kingzarII/Modular-Smart-Lighting-Control-System/Screenshot 2026-08-19 at 21.22.18.png

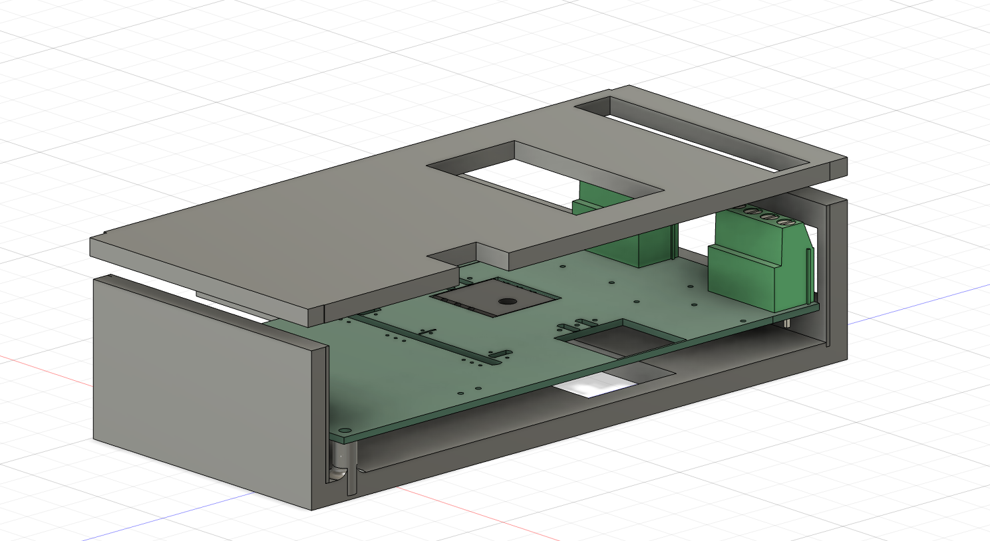
Screenshot 2026-08-19 at 21.22.18.png
