kingzarII/Modular-Smart-Lighting-Control-System/DimmerModule.step

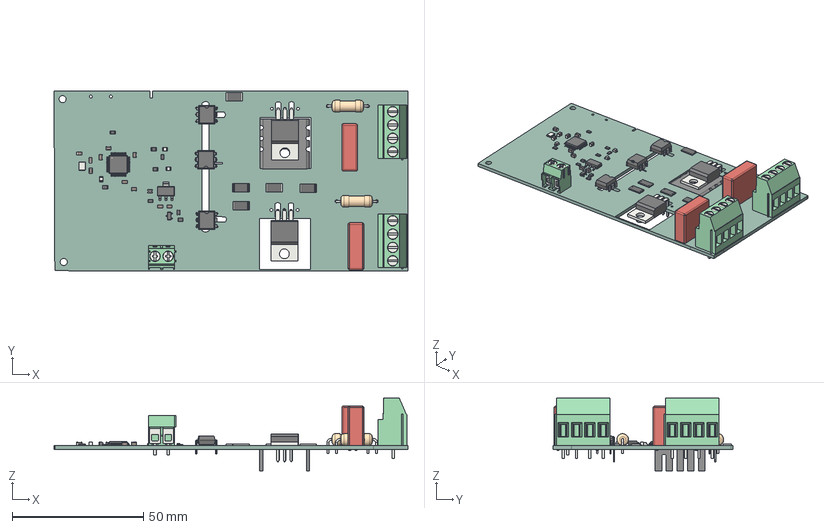
[picture p11: CAD file, 2026-08-20]
DimmerModule.step
134.8 x 68.6 x 27.7 mm
R_2512_6332Metric x 5
TO-220-3_Horizontal_TabDown x 2
LED_0805_2012Metric x 3
C_0805_2012Metric x 10
D_0805_2012Metric x 2
R_0805_2012Metric x 7
C_Rect_L18.0mm_W6.0mm_P15.00mm_FKS3_FKP3 x 2
Crystal_SMD_3225-4Pin_3.2x2.5mm
R_Axial_DIN0414_L11.9mm_D4.5mm_P15.24mm_Horizontal x 2
DIP-6_W7.62mm x 3
LQFP-48_7x7mm_P0.5mm
TerminalBlock_Phoenix_MKDS-3-4-5.08_1x04_P5.08mm_Horizontal x 2
507302B00000G--3DModel-STEP-56544
SOT-23
SOT-223
TerminalBlock_Phoenix_PT-1,5-2-5.0-H_1x02_P5.00mm_Horizontal
DimmerModule_PCB_1
DimmerModule_PCB_2
DimmerModule_PCB_3
