kingzarII/Modular-Smart-Lighting-Control-System/LinkedPartsPCB_Configuration 1_TESTPE1&.stl

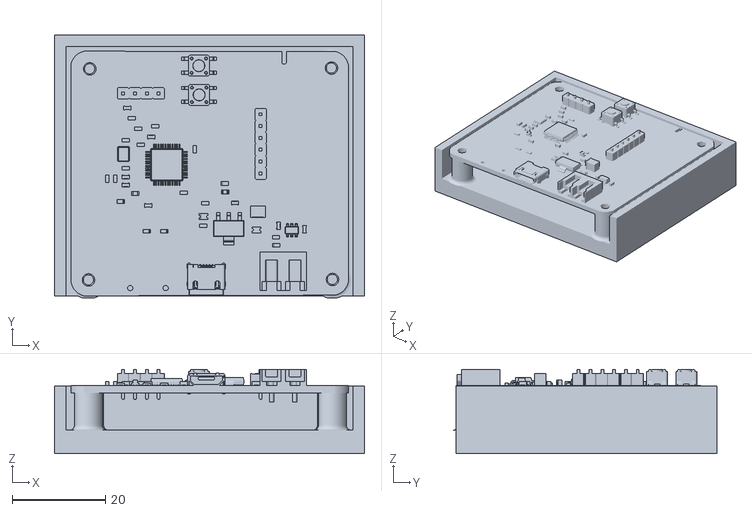
[picture p12: CAD file, 2026-08-20]
LinkedPartsPCB_Configuration 1_TESTPE1&.stl
66.6 x 56.6 x 18.1
