kingzarII/Modular-Smart-Lighting-Control-System/LinkedPartsPCB_Configuration 1_DimmerModuleCase2.stl

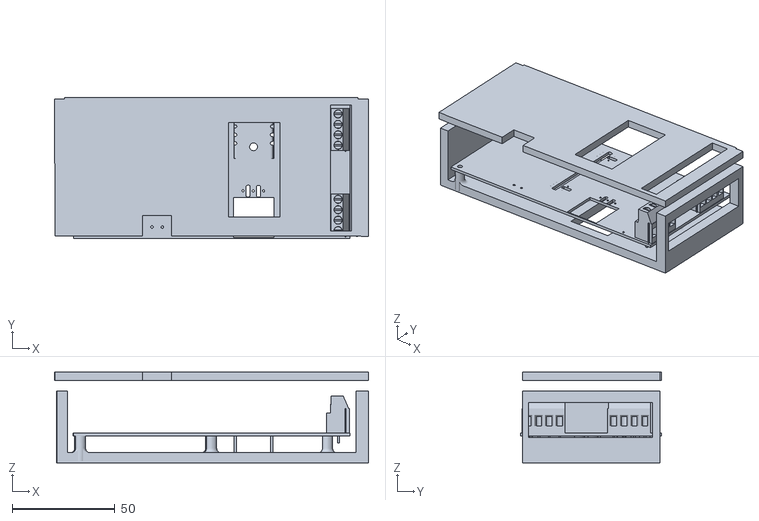
[picture p13: CAD file, 2026-08-20]
LinkedPartsPCB_Configuration 1_DimmerModuleCase2.stl
152.8 x 68.8 x 44.2
