kingzarII/Modular-Smart-Lighting-Control-System/TESTPE1.step

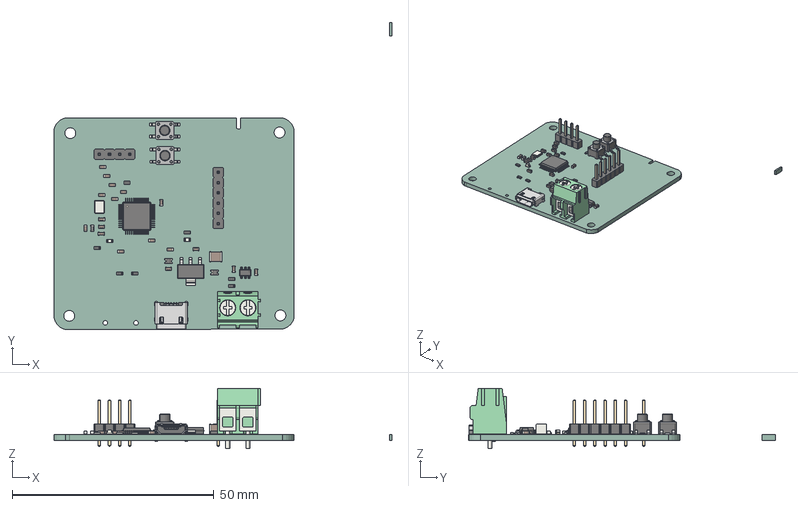
[picture p14: CAD file, 2026-08-20]
TESTPE1.step
83.9 x 76.2 x 15.0 mm
C_0603_1608Metric x 18
SOT-223
SW_SPST_TL3305B x 2
LQFP-48_7x7mm_P0.5mm
PinHeader_1x06_P2.54mm_Vertical
SOT-23-6
R_0603_1608Metric x 7
LED_0603_1608Metric x 2
Crystal_SMD_3225-4Pin_3.2x2.5mm
D_0805_2012Metric x 2
C_1210_3225Metric
TerminalBlock_Phoenix_PT-1,5-2-5.0-H_1x02_P5.00mm_Horizontal
629105150521_Housing
629105150521_Pin1 x 4
629105150521_Pin2
629105150521_Shielding2
629105150521_Shielding
PinHeader_1x04_P2.54mm_Vertical
L_0603_1608Metric
TESTPE1_PCB_1
TESTPE1_PCB_2
