kingzarII/Modular-Smart-Lighting-Control-System/Solo_dim_base.stl

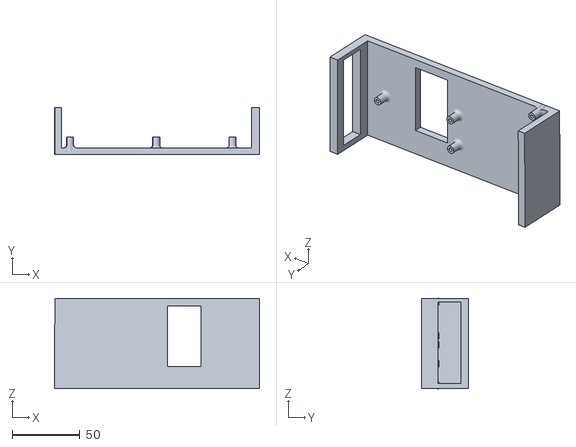
[picture p15: CAD file, 2026-08-20]
Solo_dim_base.stl
151.8 x 34.9 x 67.0
