kingzarII/Modular-Smart-Lighting-Control-System/Solo_Dim_Lid.stl

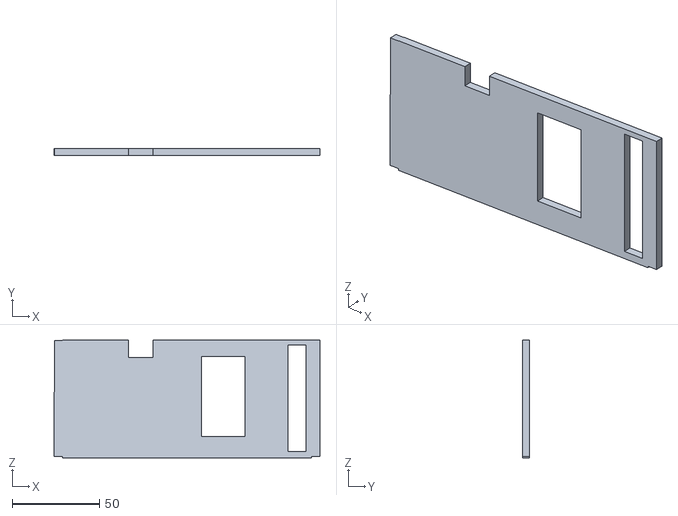
[picture p16: CAD file, 2026-08-20]
Solo_Dim_Lid.stl
152.8 x 4.00 x 67.6
