kingzarII/Modular-Smart-Lighting-Control-System/Solo_Base.stl

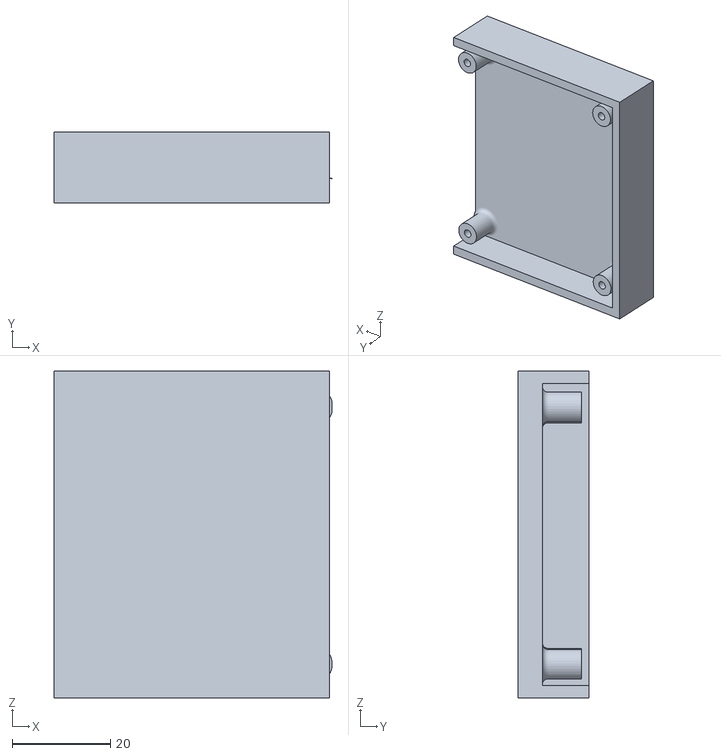
[picture p17: CAD file, 2026-08-20]
Solo_Base.stl
56.6 x 14.5 x 66.6
