kingzarII/Modular-Smart-Lighting-Control-System/DimmerModule.kicad_pcb

## KiCad design DimmerModule.kicad_pcb (2026-08-20)

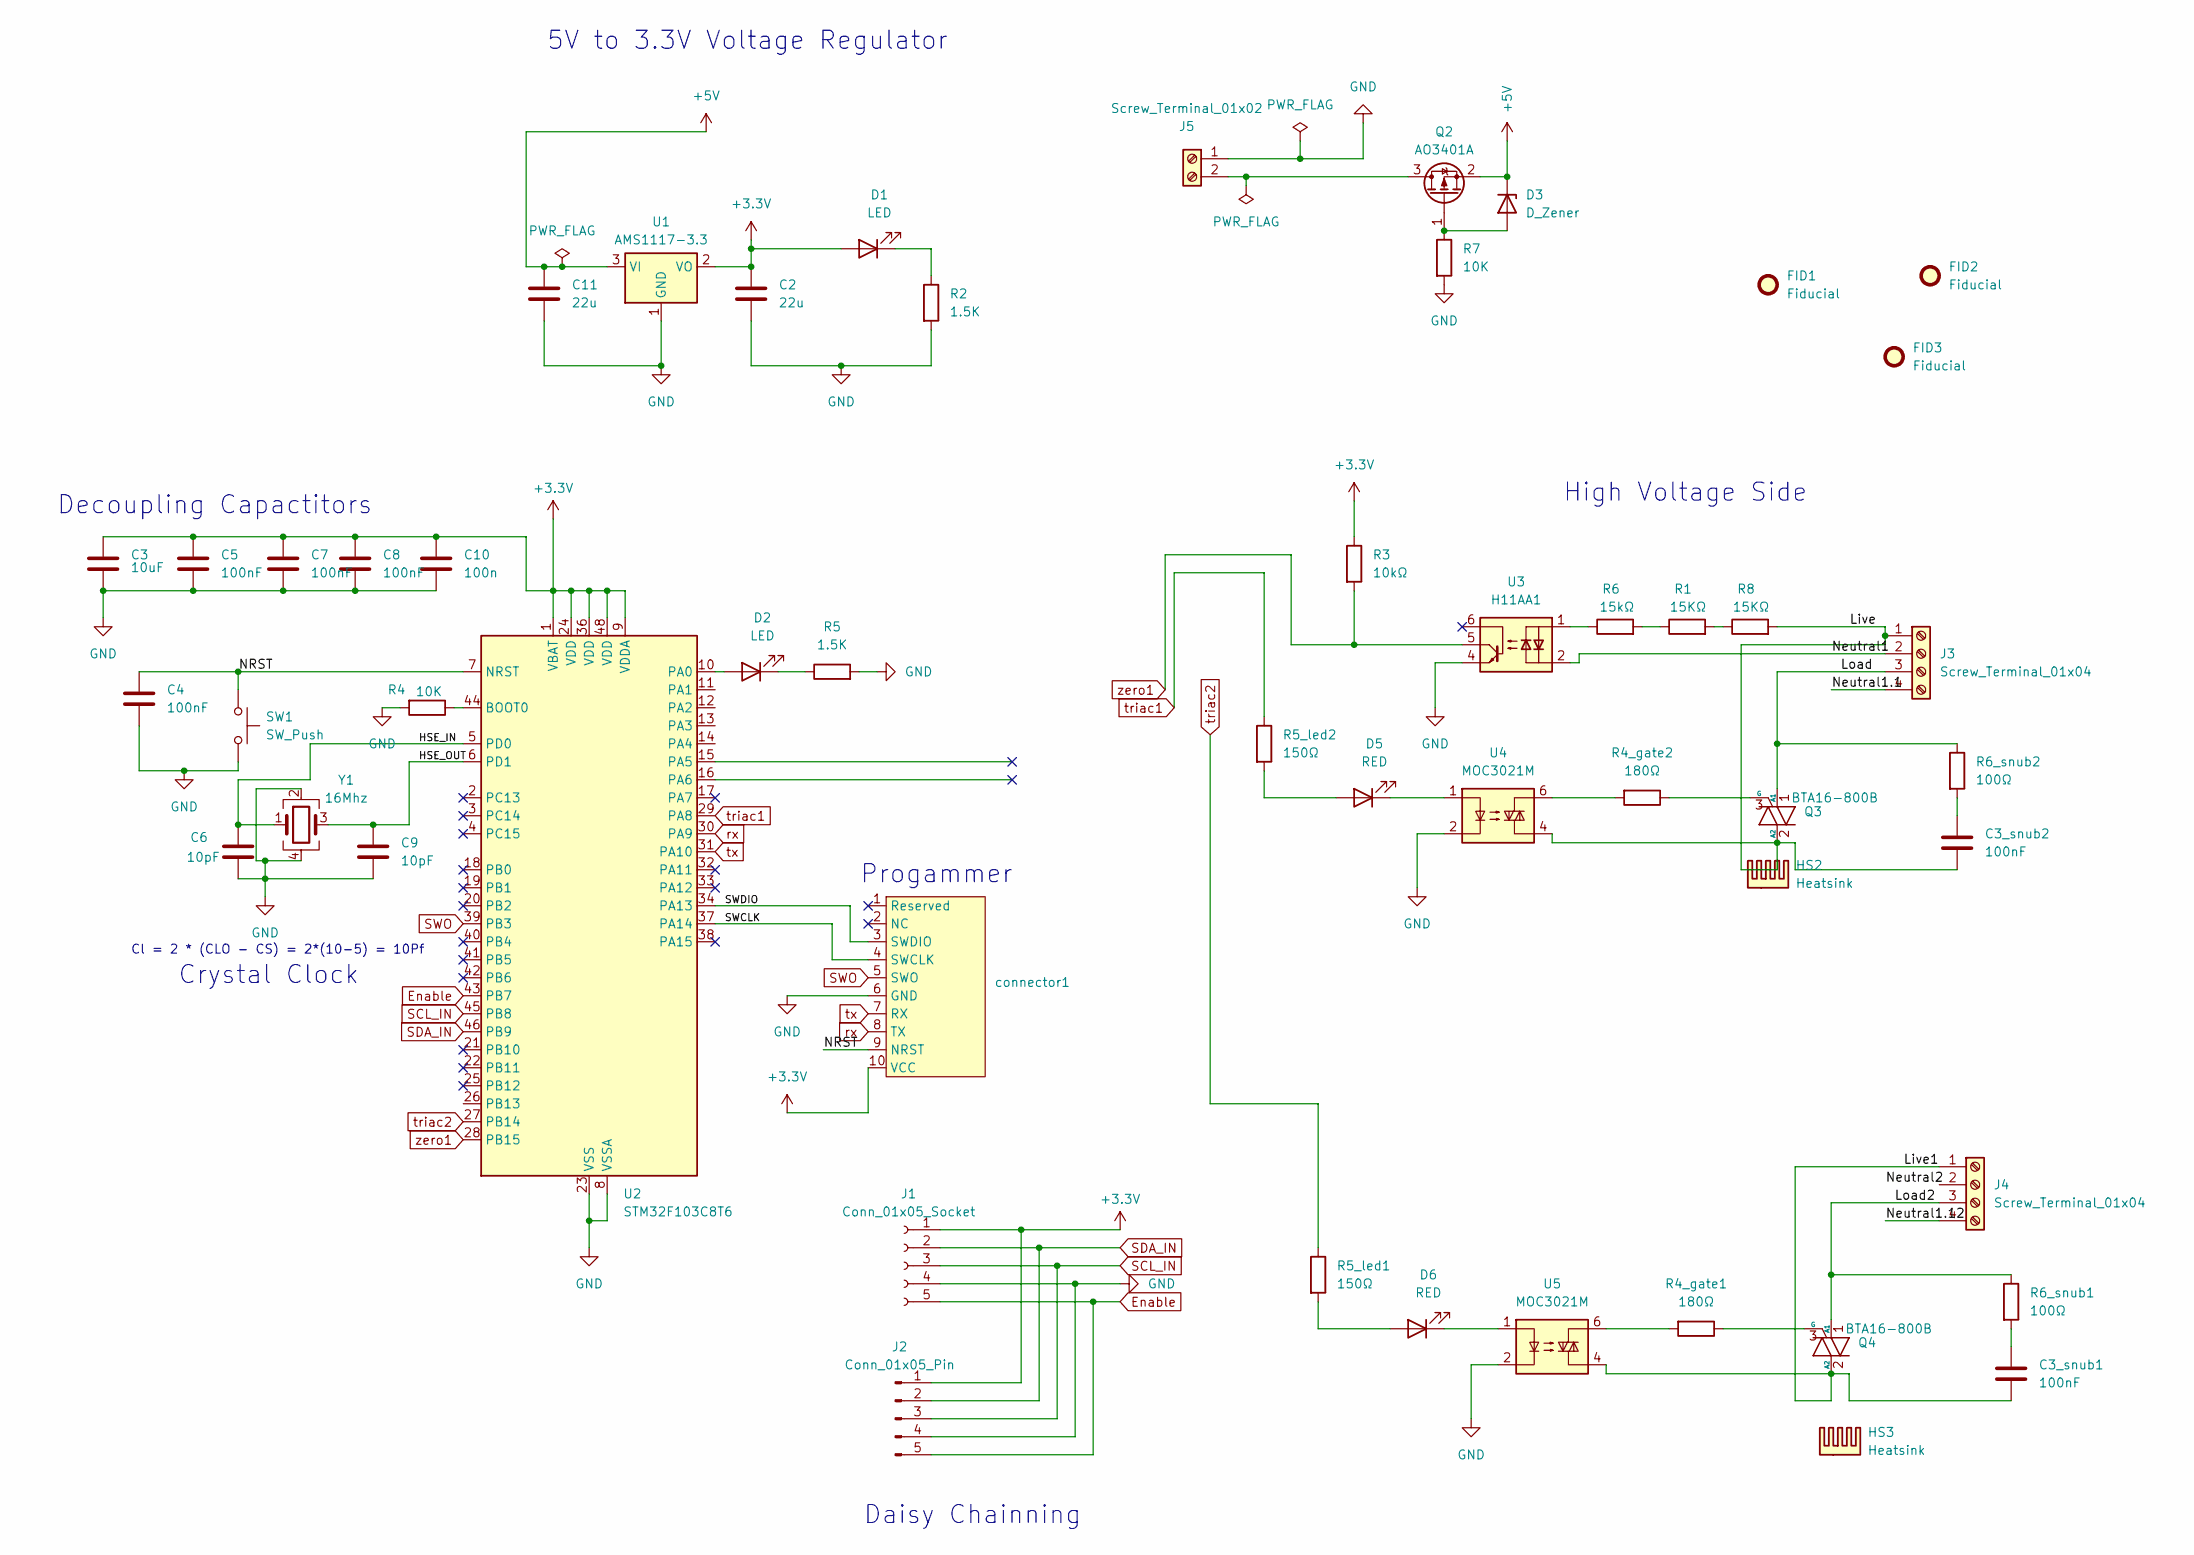
[picture p18: schematic DimmerModule.kicad_sch]

Parts:
C2, C11: 22u; C_0805_2012Metric
C3: 10uF; C_0805_2012Metric
C3_snub1, C3_snub2: 100nF; C_Rect_L18.0mm_W6.0mm_P15.00mm_FKS3_FKP3
C4, C5, C7, C8: 100nF; C_0805_2012Metric
C6, C9: 10pF; C_0805_2012Metric
C10: 100n; C_0805_2012Metric
D1: LED; D_0805_2012Metric
D2: LED; LED_0805_2012Metric
D3: D_Zener; D_0805_2012Metric
D5, D6: RED; LED_0805_2012Metric
FID1, FID2, FID3: Fiducial; Fiducial_1mm_Mask2mm
HS2, HS3: Heatsink; cooler
J1: Conn_01x05_Socket; 1156901
J2: Conn_01x05_Pin; 1156939
J3, J4: Screw_Terminal_01x04; TerminalBlock_Phoenix_MKDS-3-4-5.08_1x04_P5.08mm_Horizontal
J5: Screw_Terminal_01x02; TerminalBlock_Phoenix_PT-1,5-2-5.0-H_1x02_P5.00mm_Horizontal
Q2: AO3401A; SOT-23
Q3, Q4: BTA16-800B; TO-220-3_Horizontal_TabDown
R1, R8: 15KΩ; R_2512_6332Metric
R2, R5: 1.5K; R_0805_2012Metric
R3: 10kΩ; R_0805_2012Metric
R4, R7: 10K; R_0805_2012Metric
R4_gate1, R4_gate2: 180Ω; R_2512_6332Metric
R5_led1, R5_led2: 150Ω; R_0805_2012Metric
R6: 15kΩ; R_2512_6332Metric
R6_snub1, R6_snub2: 100Ω; R_Axial_DIN0414_L11.9mm_D4.5mm_P15.24mm_Horizontal
SW1: SW_Push; SW_SPST_TL3305B
U1: AMS1117-3.3; SOT-223-3_TabPin2
U2: STM32F103C8T6; LQFP-48_7x7mm_P0.5mm
U3: H11AA1; DIP-6_W7.62mm
U4, U5: MOC3021M; DIP-6_W7.62mm
Y1: 16Mhz; Crystal_SMD_3225-4Pin_3.2x2.5mm
connector1: Open Ended Card Edge

Connections:
+3.3V: C2.1, C3.1, C5.1, C7.1, C8.1, C10.1, D1.2 (A), J1.1, J2.1, R3.1, U1.2 (VO), U2.1 (VBAT), U2.9 (VDDA), U2.24 (VDD), U2.36 (VDD), U2.48 (VDD), connector1.10 (VCC)
+5V: C11.1, D3.1 (K), Q2.2 (S), U1.3 (VI)
/HSE_IN: C6.1, U2.5 (PD0), Y1.1
/HSE_OUT: C9.1, U2.6 (PD1), Y1.3
/Live: C3_snub2.2, J3.1, Q3.2 (A2), R8.2, U4.4
/Live1: C3_snub1.2, J4.1, Q4.2 (A2), U5.4
/Load: J3.3, Q3.1 (A1), R6_snub2.1
/Load2: J4.3, Q4.1 (A1), R6_snub1.1
/NRST: C4.1, SW1.1, U2.7 (NRST), connector1.9 (NRST)
/Neutral1: J3.2, U3.2
/Neutral1.1: J3.4
/Neutral1.12: J4.4
/SWCLK: U2.37 (PA14), connector1.4 (SWCLK)
/SWDIO: U2.34 (PA13), connector1.3 (SWDIO)
Enable: J1.5, J2.5, U2.43 (PB7)
GND: C2.2, C3.2, C4.2, C5.2, C6.2, C7.2, C8.2, C9.2, C10.2, C11.2, J1.4, J2.4, J5.1, R2.2, R4.2, R5.2, R7.2, SW1.2, U1.1 (GND), U2.8 (VSSA), U2.23 (VSS), U2.35 (VSS), U2.47 (VSS), U3.4, U4.2, U5.2, Y1.2, Y1.4, connector1.6 (GND)
unnamed: C3_snub1.1, R6_snub1.2
unnamed: C3_snub2.1, R6_snub2.2
unnamed: D1.1 (K), R2.1
unnamed: D2.2 (A), U2.10 (PA0)
unnamed: D2.1 (K), R5.1
unnamed: D3.2 (A), Q2.1 (G), R7.1
unnamed: D5.2 (A), R5_led2.2
unnamed: D5.1 (K), U4.1
unnamed: D6.2 (A), R5_led1.2
unnamed: D6.1 (K), U5.1
unnamed: J5.2, Q2.3 (D)
unnamed: Q3.3 (G), R4_gate2.1
unnamed: Q4.3 (G), R4_gate1.1
unnamed: R1.1, R6.2
unnamed: R1.2, R8.1
unnamed: R4_gate1.2, U5.6
unnamed: R4_gate2.2, U4.6
unnamed: R6.1, U3.1
unnamed: R4.1, U2.44 (BOOT0)
SCL_IN: J1.3, J2.3, U2.45 (PB8)
SDA_IN: J1.2, J2.2, U2.46 (PB9)
SWO: U2.39 (PB3), connector1.5 (SWO)
rx: U2.30 (PA9), connector1.8 (TX)
triac1: R5_led2.1, U2.29 (PA8)
triac2: R5_led1.1, U2.27 (PB14)
tx: U2.31 (PA10), connector1.7 (RX)
zero1: R3.2, U2.28 (PB15), U3.5

Notes on the sheet:
High Voltage Side
Decoupling Capactitors
Cl = 2 * (CLO - CS) = 2*(10-5) = 10Pf
Progammer
Crystal Clock
5V to 3.3V Voltage Regulator
Daisy Chainning

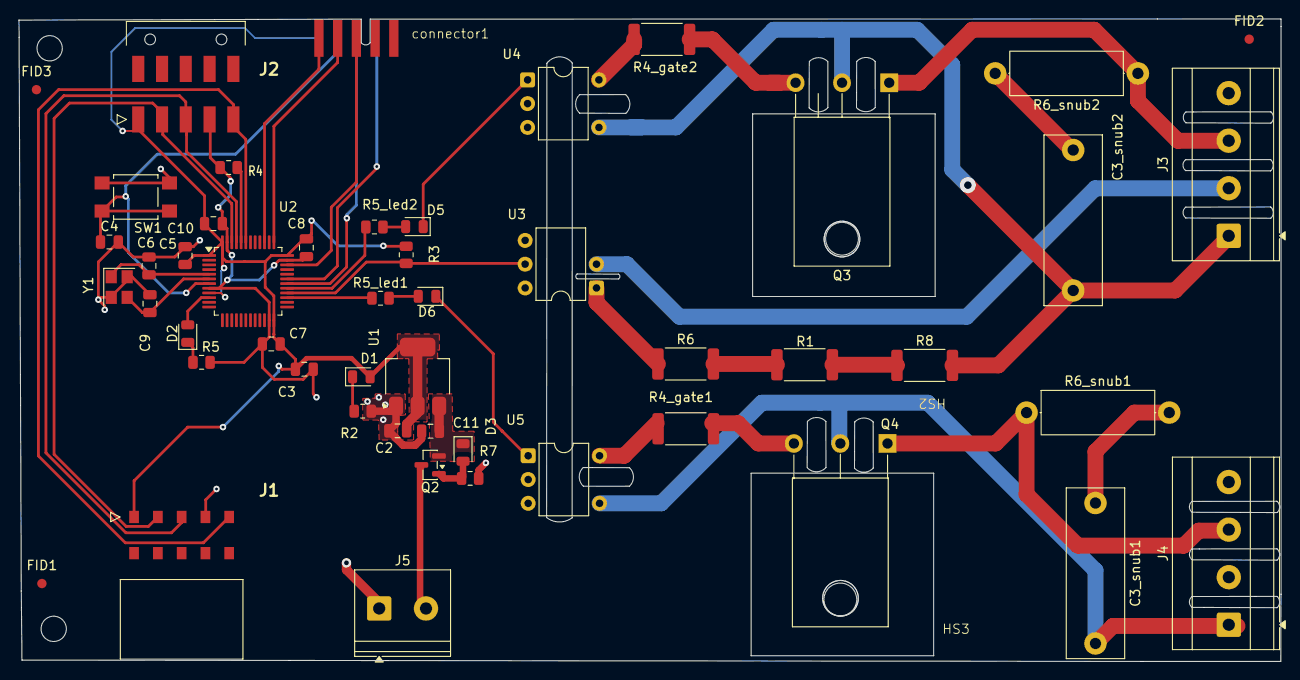
[picture p19: board DimmerModule.kicad_pcb from above]

Board: 2 copper layers, 134.8 x 68.6 mm, 54 parts (0 on the bottom side), 41 nets.

Other parts of the board:
H1, H1#2: MountingHole; MountingHole_2.7mm_M2.5
