kingzarII/Modular-Smart-Lighting-Control-System/TESTPE1.kicad_pcb

## KiCad design TESTPE1.kicad_pcb (2026-08-20)

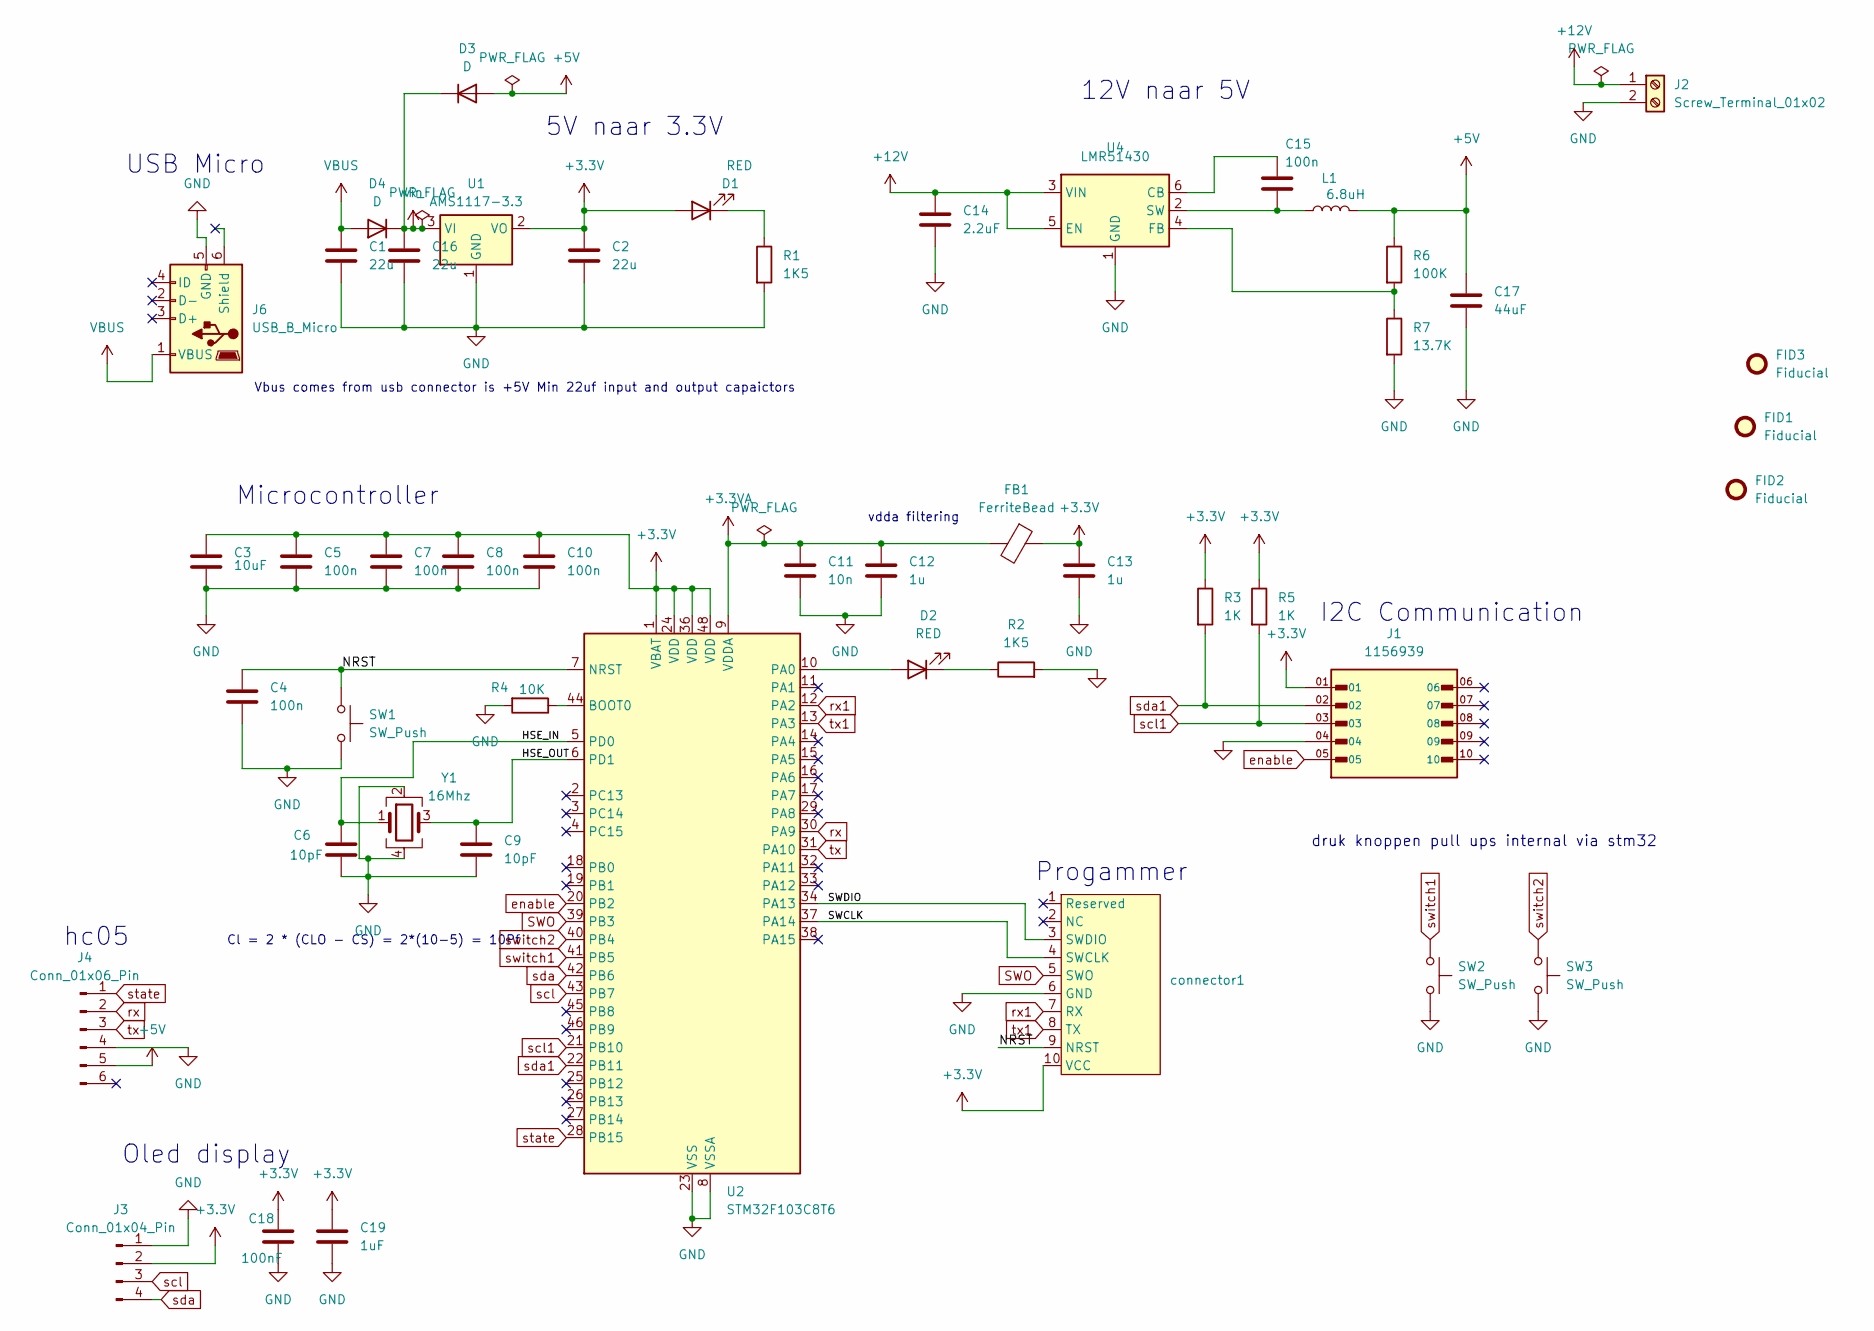
[picture p20: schematic TESTPE1.kicad_sch]

Parts:
C1, C2, C16: 22u; C_0603_1608Metric
C3: 10uF; C_0603_1608Metric
C4, C5, C7, C8, C10, C15: 100n; C_0603_1608Metric
C6, C9: 10pF; C_0603_1608Metric
C11: 10n; C_0603_1608Metric
C12, C13: 1u; C_0603_1608Metric
C14: 2.2uF; C_0603_1608Metric
C17: 44uF; C_1210_3225Metric
C18: 100nF; C_0603_1608Metric
C19: 1uF; C_0603_1608Metric
D1, D2: RED; LED_0603_1608Metric
D3, D4: D; D_0805_2012Metric
FB1: FerriteBead; L_0603_1608Metric
FID1, FID2, FID3: Fiducial; Fiducial_1mm_Mask2mm
J1: 1156939; PHOENIX_1156939; PARTREV 25.06.2021
J2: Screw_Terminal_01x02; TerminalBlock_Phoenix_PT-1,5-2-5.0-H_1x02_P5.00mm_Horizontal
J3: Conn_01x04_Pin; PinHeader_1x04_P2.54mm_Vertical
J4: Conn_01x06_Pin; PinHeader_1x06_P2.54mm_Vertical
J6: USB_B_Micro; USB_Micro-B_Wuerth_629105150521
L1: 6.8uH; IND_1273AS-H-6R8N=P3
R1, R2: 1K5; R_0603_1608Metric
R3, R5: 1K; R_0603_1608Metric
R4: 10K; R_0603_1608Metric
R6: 100K; R_0603_1608Metric
R7: 13.7K; R_0603_1608Metric
SW1, SW2, SW3: SW_Push; SW_SPST_TL3305B
U1: AMS1117-3.3; SOT-223-3_TabPin2
U2: STM32F103C8T6; LQFP-48_7x7mm_P0.5mm
U4: LMR51430; SOT-23-6
Y1: 16Mhz; Crystal_SMD_3225-4Pin_3.2x2.5mm
connector1: Open Ended Card Edge

Connections:
+3.3V: C2.1, C3.1, C5.1, C7.1, C8.1, C10.1, C13.1, C18.1, C19.1, D1.2 (A), FB1.1, J1.01, J3.2, R3.1, R5.1, U1.2 (VO), U2.1 (VBAT), U2.24 (VDD), U2.36 (VDD), U2.48 (VDD), connector1.10 (VCC)
+3.3VA: C11.1, C12.1, FB1.2, U2.9 (VDDA)
+5V: C17.1, D3.2 (A), J4.5, L1.2, R6.1
+12V: C14.1, J2.1, U4.3 (VIN), U4.5 (EN)
/HSE_IN: C6.1, U2.5 (PD0), Y1.1
/HSE_OUT: C9.1, U2.6 (PD1), Y1.3
/NRST: C4.1, SW1.1, U2.7 (NRST), connector1.9 (NRST)
/SWCLK: U2.37 (PA14), connector1.4 (SWCLK)
/SWDIO: U2.34 (PA13), connector1.3 (SWDIO)
GND: C1.2, C2.2, C3.2, C4.2, C5.2, C6.2, C7.2, C8.2, C9.2, C10.2, C11.2, C12.2, C13.2, C14.2, C16.2, C17.2, C18.2, C19.2, J1.04, J2.2, J3.1, J4.4, J6.5 (GND), R1.2, R2.2, R4.2, R7.2, SW1.2, SW2.2, SW3.2, U1.1 (GND), U2.8 (VSSA), U2.23 (VSS), U2.35 (VSS), U2.47 (VSS), U4.1 (GND), Y1.2, Y1.4, connector1.6 (GND)
unnamed: D1.1 (K), R1.1
unnamed: D2.2 (A), U2.10 (PA0)
unnamed: D2.1 (K), R2.1
unnamed: R4.1, U2.44 (BOOT0)
unnamed: C15.1, U4.6 (CB)
unnamed: R6.2, R7.1, U4.4 (FB)
unnamed: C15.2, L1.1, U4.2 (SW)
SWO: U2.39 (PB3), connector1.5 (SWO)
VBUS: C1.1, D4.2 (A), J6.1 (VBUS)
enable: J1.05, U2.20 (PB2)
rx: J4.2, U2.30 (PA9)
rx1: U2.12 (PA2), connector1.7 (RX)
scl: J3.3, U2.43 (PB7)
scl1: J1.03, R5.2, U2.21 (PB10)
sda: J3.4, U2.42 (PB6)
sda1: J1.02, R3.2, U2.22 (PB11)
state: J4.1, U2.28 (PB15)
switch1: SW2.1, U2.41 (PB5)
switch2: SW3.1, U2.40 (PB4)
tx: J4.3, U2.31 (PA10)
tx1: U2.13 (PA3), connector1.8 (TX)
vin: C16.1, D3.1 (K), D4.1 (K), U1.3 (VI)

Notes on the sheet:
Progammer
I2C Communication
hc05
5V naar 3.3V
Oled display
USB Micro
Microcontroller
Cl = 2 * (CLO - CS) = 2*(10-5) = 10Pf
Vbus comes from usb connector is +5V Min 22uf input and output capaictors
druk knoppen pull ups internal via stm32
12V naar 5V
vdda filtering

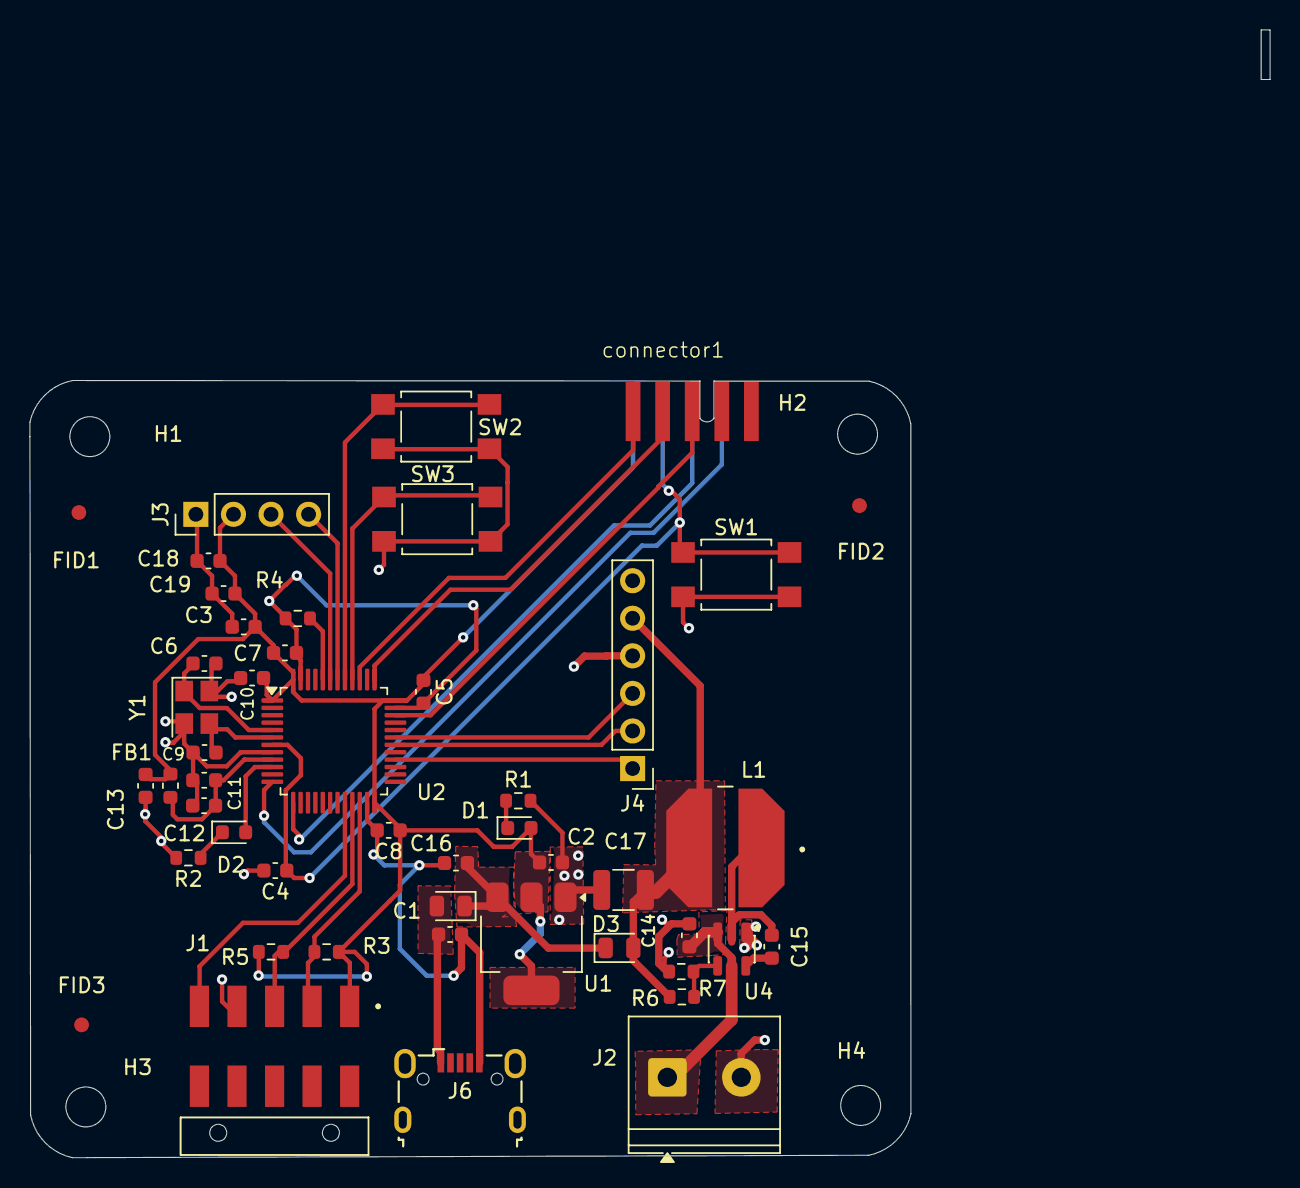
[picture p21: board TESTPE1.kicad_pcb from above]

Board: 2 copper layers, 59.6 x 52.5 mm, 52 parts (0 on the bottom side), 32 nets.

Other parts of the board:
H1, H2, H3, H4: MountingHole; MountingHole_2.7mm_M2.5
